bjohan/adf5355/adf5355/adf5355.pdf

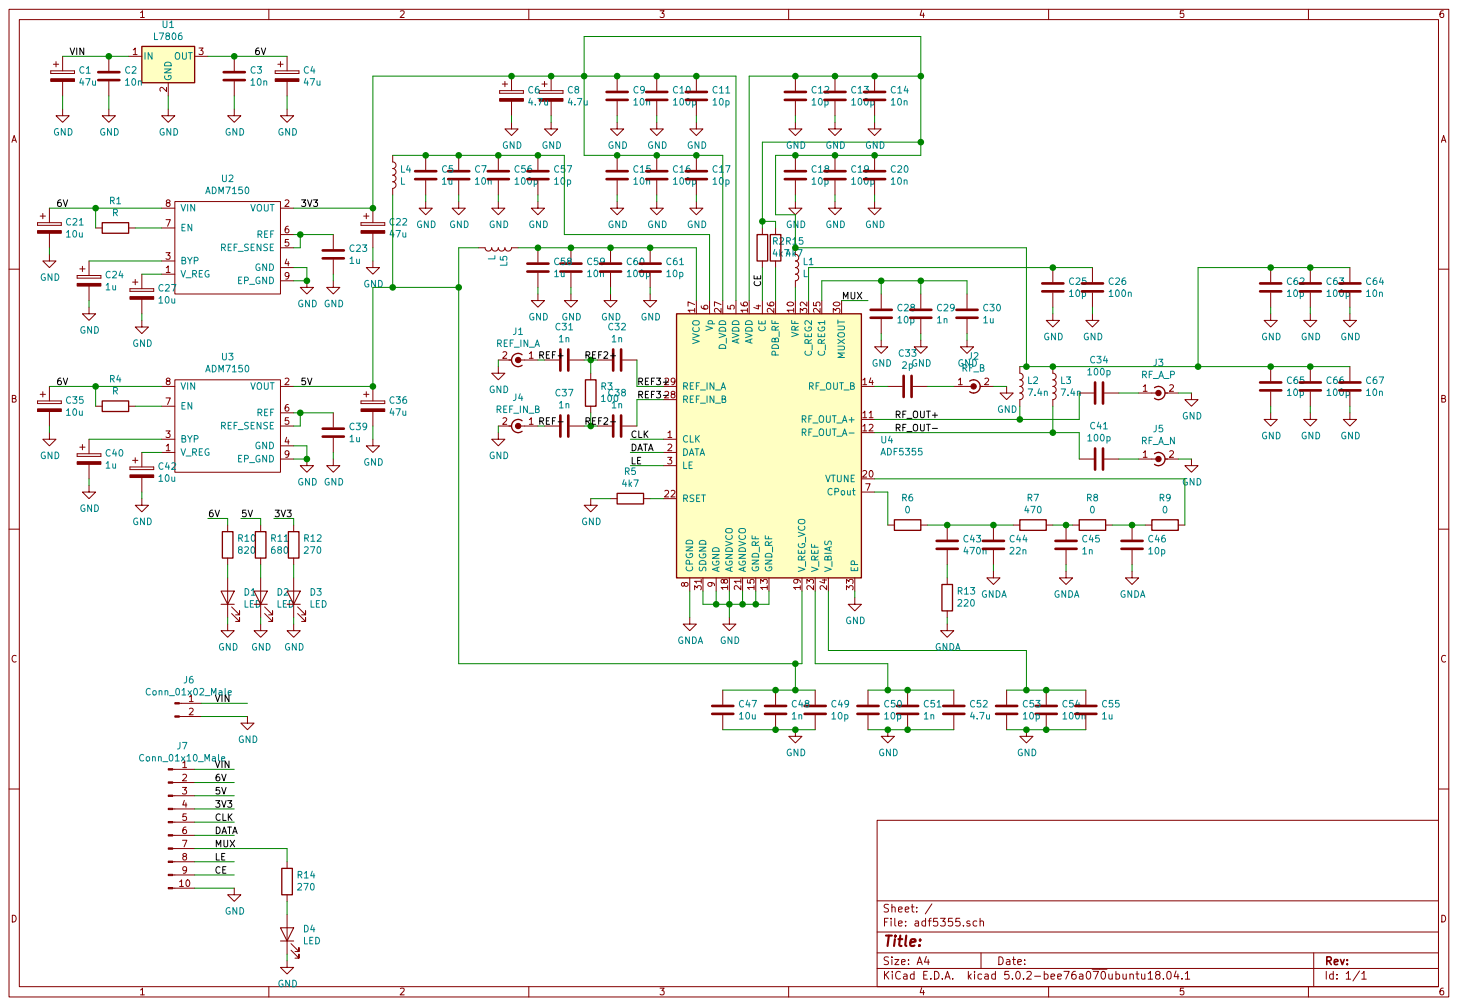
[picture p1: page 1]

9 U4ADF5355 V_REG 1 VOUT 2 BYP 3 GND 4 REF_SENSE 5 REF EN 6

47u GND GND GND GND

Id: 1/1 Title: File: adf5355.sch Sheet: /
