bjohan/adf5355/adf_arduino_adapter/adf_arduino_adapter/adf_arduino_adapter.kicad_pcb

## KiCad design adf_arduino_adapter/adf_arduino_adapter/adf_arduino_adapter.kicad_pcb (2019-05-01)

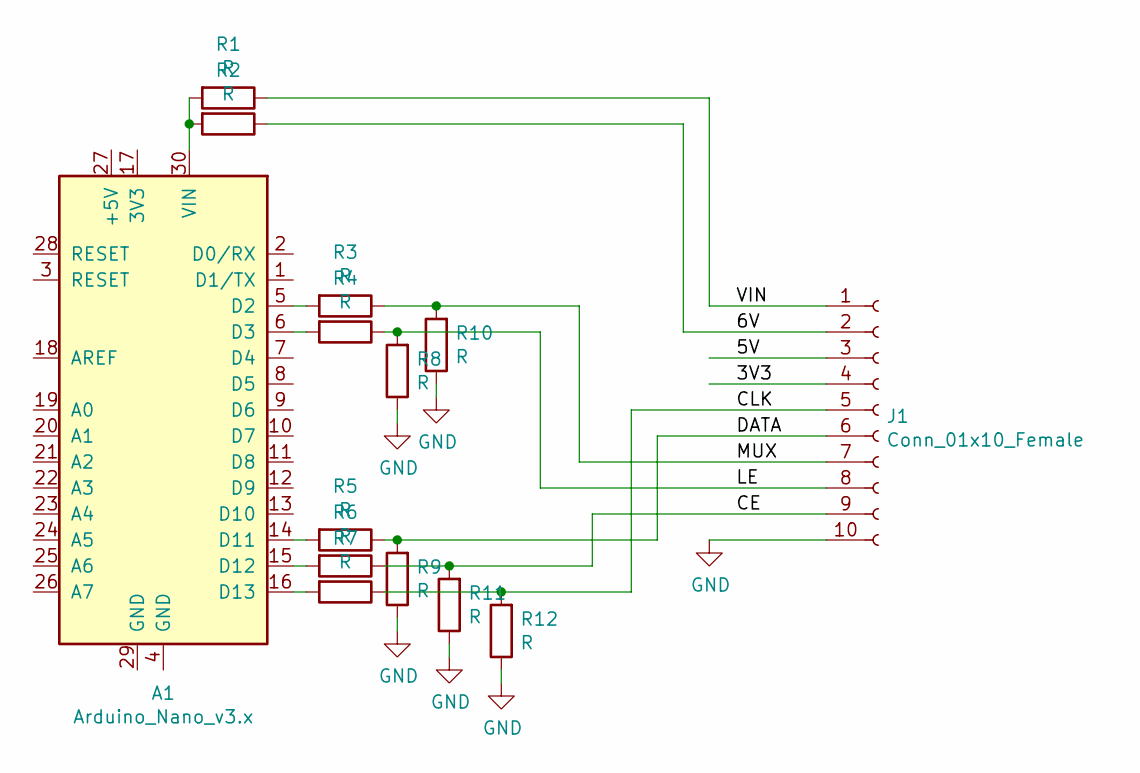
[picture p2: schematic adf_arduino_adapter.sch]

Parts:
A1: Arduino_Nano_v3.x; Arduino_Nano
J1: Conn_01x10_Female; Molex_KK-254_AE-6410-10A_1x10_P2.54mm_Vertical
R1, R2, R3, R4, R5, R6, R7, R8, R9, R10, R11, R12: R; R_1206_3216Metric_Pad1.42x1.75mm_HandSolder

Connections:
/3V3: J1.4
/5V: J1.3
/6V: J1.2, R2.1
/CE: J1.9, R6.1, R11.2
/CLK: J1.5, R7.1, R12.2
/DATA: J1.6, R5.1, R9.2
/LE: J1.8, R4.1, R8.2
/MUX: J1.7, R3.1, R10.2
/VIN: J1.1, R1.1
GND: J1.10, R8.1, R9.1, R10.1, R11.1, R12.1
unnamed: A1.5 (D2), R3.2
unnamed: A1.6 (D3), R4.2
unnamed: A1.14 (D11), R5.2
unnamed: A1.15 (D12), R6.2
unnamed: A1.16 (D13), R7.2
unnamed: A1.30 (VIN), R1.2, R2.2

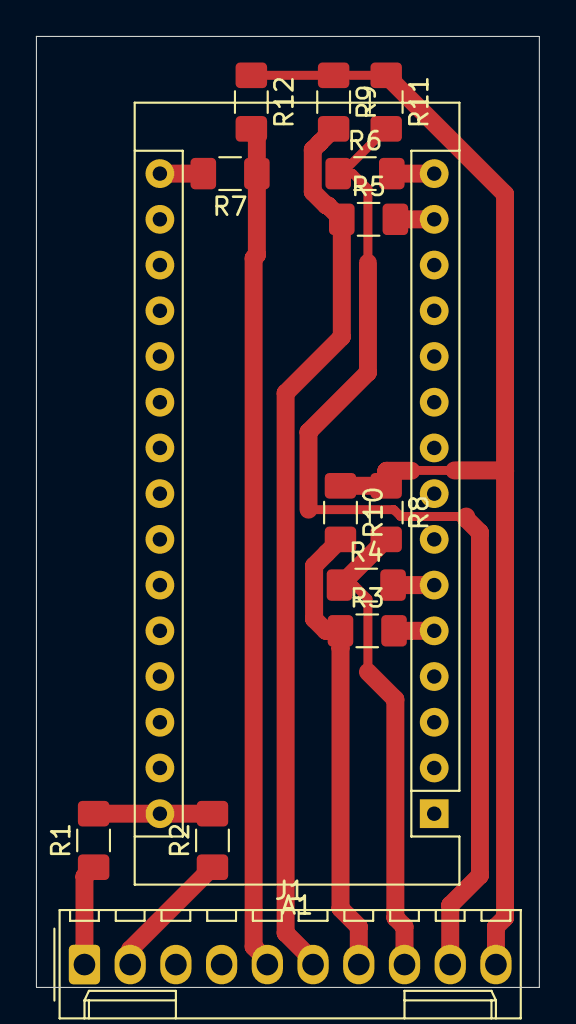
[picture p3: board adf_arduino_adapter.kicad_pcb from above]

Board: 2 copper layers, 27.9 x 52.8 mm, 14 parts (0 on the bottom side), 14 nets.
