bjohan/adf5355/adf5355/adf5355.kicad_pcb

## KiCad design adf5355/adf5355.kicad_pcb (2019-01-26)

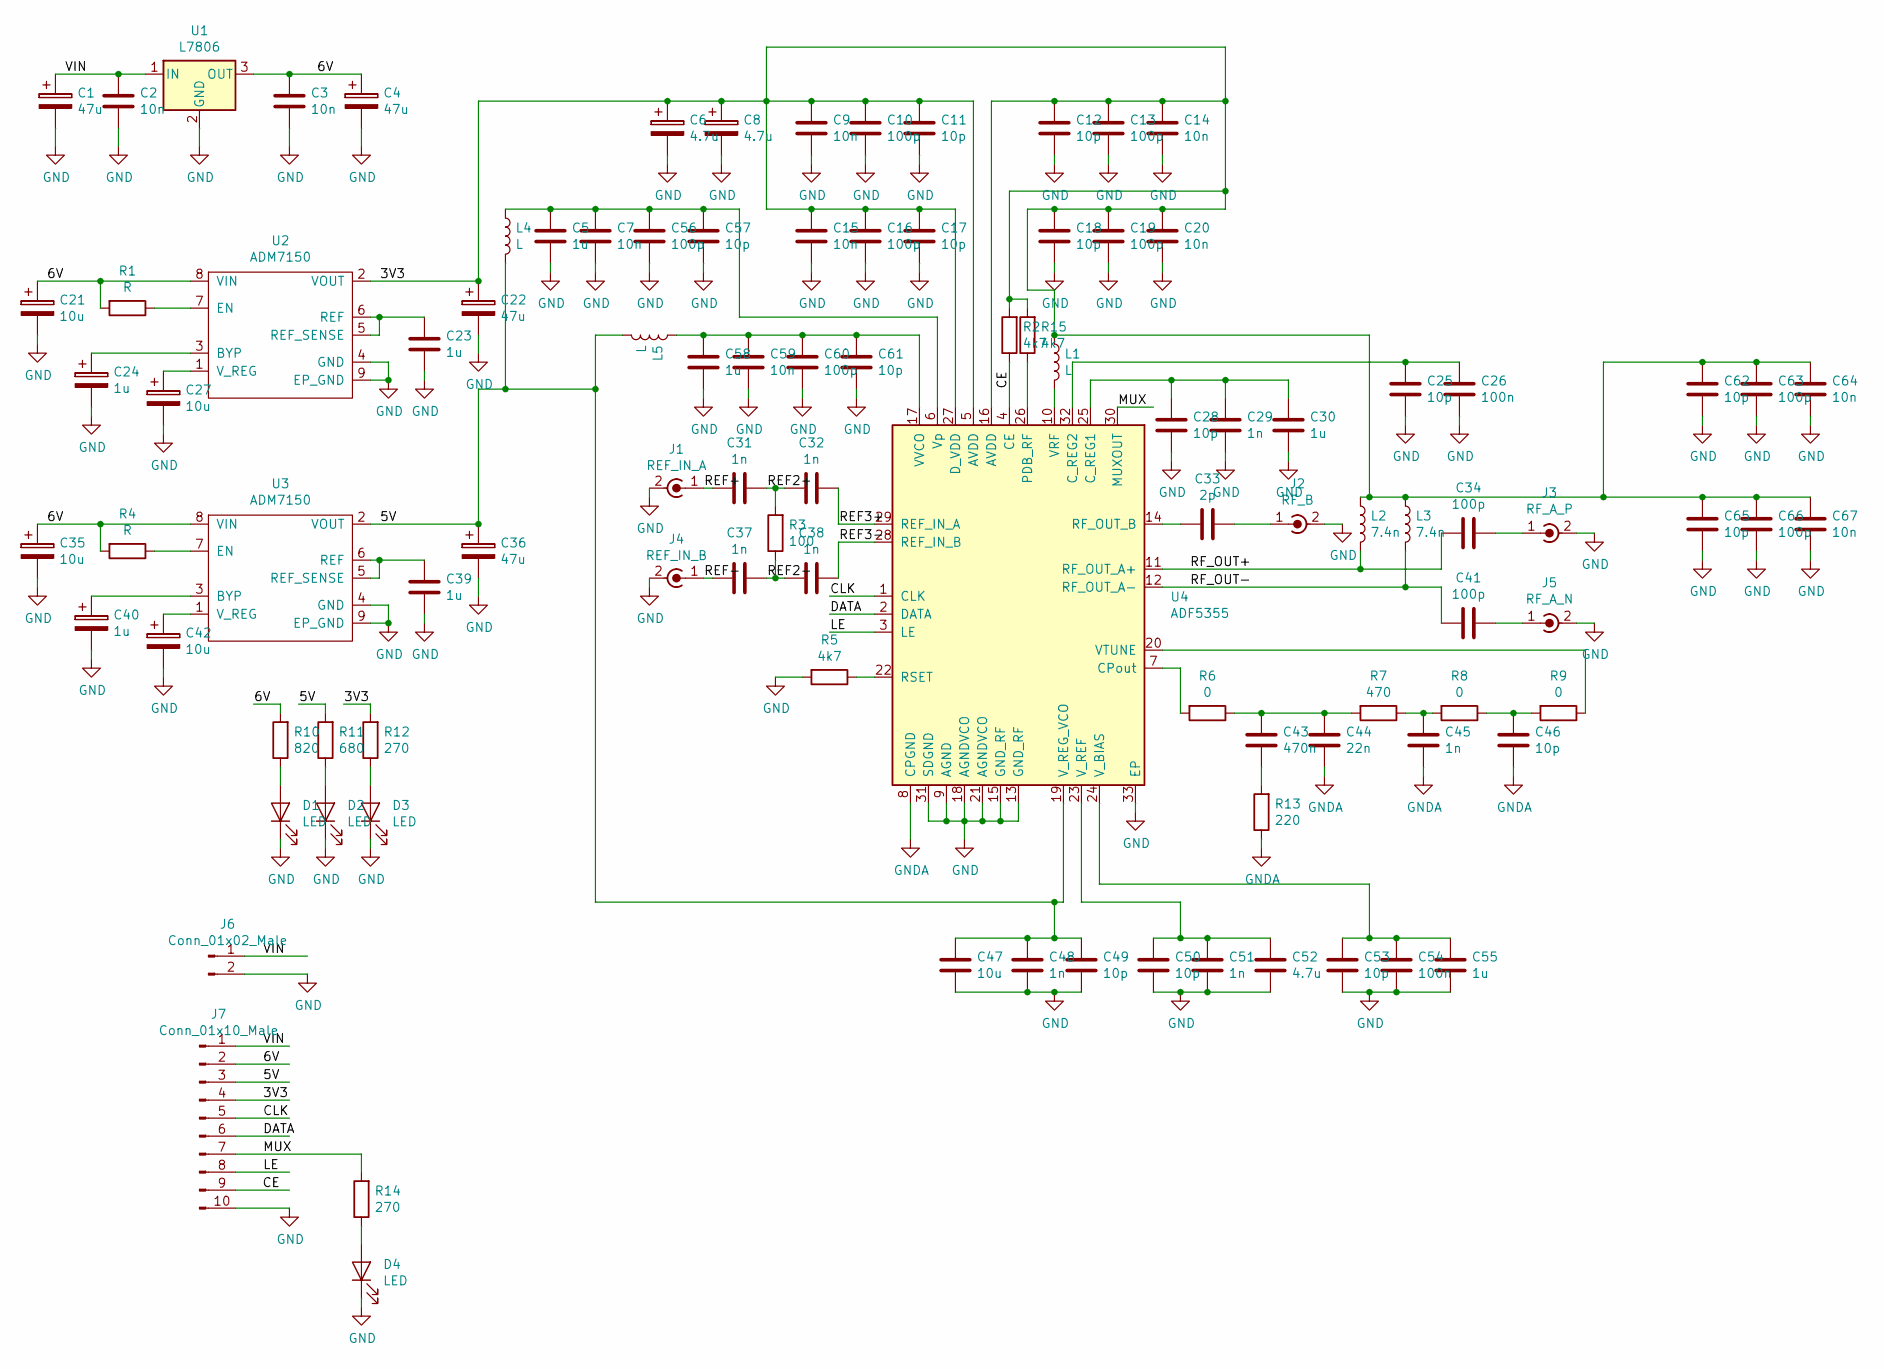
[picture p4: schematic adf5355.sch]

Parts:
C1, C4, C22, C36: 47u; CP_Elec_4x4.5
C2, C3: 10n; C_0805
C5, C30, C55, C58: 1u; C_0603
C6, C8: 4.7u; C_1812
C7, C9, C14, C15, C20, C59, C64, C67: 10n; C_0603
C10, C13, C16, C19, C34, C41, C56, C60, C63, C66: 100p; C_0603
C11, C12, C17, C18, C25, C28, C46, C49, C50, C53, C57, C61, C62, C65: 10p; C_0603
C21, C27, C35, C42, C47: 10u; C_1812
C23, C24, C39, C40: 1u; C_1206
C26, C54: 100n; C_0603
C29, C31, C32, C37, C38, C45, C48, C51: 1n; C_0603
C33: 2p; C_0603
C43: 470n; C_0603
C44: 22n; C_0603
C52: 4.7u; C_0603
D1, D2, D3, D4: LED; LED_0805
J1: REF_IN_A; SMA_THT_Jack_Straight
J2: RF_B; SMA_THT_Jack_Straight
J3: RF_A_P; SMA_THT_Jack_Straight
J4: REF_IN_B; SMA_THT_Jack_Straight
J5: RF_A_N; SMA_THT_Jack_Straight
J6: Conn_01x02_Male; Molex_KK-6410-02_02x2.54mm_Straight
J7: Conn_01x10_Male; Molex_KK-6410-10_10x2.54mm_Straight
L1, L4, L5: L; C_0805_HandSoldering
L2, L3: 7.4n; C_0805_HandSoldering
R1, R4: R; R_0805
R2, R5, R15: 4k7; R_0805
R3: 100; R_0805
R6, R8, R9: 0; R_0603
R7: 470; R_0603
R10: 820; R_0805
R11: 680; R_0805
R12, R14: 270; R_0805
R13: 220; R_0603
U1: L7806; TO-220-3_Vertical
U2, U3: ADM7150; SOIC-8-1EP_3.9x4.9mm_Pitch1.27mm
U4: ADF5355; LFCSP-32-1EP_5x5mm_P0.5mm_EP3.25x3.25mm

Connections:
/3V3: C6.1, C8.1, C9.1, C10.1, C11.1, C12.1, C13.1, C14.1, C15.1, C16.1, C17.1, C18.1, C19.1, C20.1, C22.1, C62.1, C63.1, C64.1, C65.1, C66.1, C67.1, J7.4, L1.1, L2.1, L3.1, R2.2, R12.2, R15.2, U2.2 (VOUT), U4.5 (AVDD), U4.16 (AVDD), U4.27 (D_VDD)
/5V: C36.1, C47.1, C48.1, C49.1, J7.3, L4.2, L5.2, R11.2, U3.2 (VOUT), U4.19 (V_REG_VCO)
/6V: C3.1, C4.1, C21.1, C35.1, J7.2, R1.2, R4.2, R10.2, U1.3 (OUT), U2.8 (VIN), U3.8 (VIN)
/CE: J7.9, R2.1, U4.4 (CE)
/CLK: J7.5, U4.1 (CLK)
/DATA: J7.6, U4.2 (DATA)
/LE: J7.8, U4.3 (LE)
/MUX: J7.7, R14.2, U4.30 (MUXOUT)
/REF2+: C31.1, C32.2, R3.2
/REF2-: C37.1, C38.2, R3.1
/REF3+: C32.1, U4.29 (REF_IN_A)
/REF3-: C38.1, U4.28 (REF_IN_B)
/REF+: C31.2, J1.1 (In)
/REF-: C37.2, J4.1 (In)
/RF_OUT+: C34.2, L2.2, U4.11 (RF_OUT_A+)
/RF_OUT-: C41.2, L3.2, U4.12 (RF_OUT_A-)
/VIN: C1.1, C2.1, J6.1, J7.1, U1.1 (IN)
GND: C1.2, C2.2, C3.2, C4.2, C5.2, C6.2, C7.2, C8.2, C9.2, C10.2, C11.2, C12.2, C13.2, C14.2, C15.2, C16.2, C17.2, C18.2, C19.2, C20.2, C21.2, C22.2, C23.2, C24.2, C25.2, C26.2, C27.2, C28.2, C29.2, C30.2, C35.2, C36.2, C39.2, C40.2, C42.2, C47.2, C48.2, C49.2, C50.2, C51.2, C52.2, C53.2, C54.2, C55.2, C56.2, C57.2, C58.2, C59.2, C60.2, C61.2, C62.2, C63.2, C64.2, C65.2, C66.2, C67.2, D1.1 (K), D2.1 (K), D3.1 (K), D4.1 (K), J1.2 (Ext), J2.2 (Ext), J3.2 (Ext), J4.2 (Ext), J5.2 (Ext), J6.2, J7.10, R5.2, U1.2 (GND), U2.4 (GND), U2.9 (EP_GND), U3.4 (GND), U3.9 (EP_GND), U4.9 (AGND), U4.13 (GND_RF), U4.15 (GND_RF), U4.18 (AGNDVCO), U4.21 (AGNDVCO), U4.31 (SDGND), U4.33 (EP)
GNDA: C44.2, C45.2, C46.2, R13.1, U4.8 (CPGND)
unnamed: C5.1, C7.1, C56.1, C57.1, L4.1, U4.6 (Vp)
unnamed: C23.1, U2.5 (REF_SENSE), U2.6 (REF)
unnamed: C24.1, U2.3 (BYP)
unnamed: C25.1, C26.1, U4.32 (C_REG2)
unnamed: C27.1, U2.1 (V_REG)
unnamed: C28.1, C29.1, C30.1, U4.25 (C_REG1)
unnamed: C33.1, J2.1 (In)
unnamed: C33.2, U4.14 (RF_OUT_B)
unnamed: C34.1, J3.1 (In)
unnamed: C39.1, U3.5 (REF_SENSE), U3.6 (REF)
unnamed: C40.1, U3.3 (BYP)
unnamed: C41.1, J5.1 (In)
unnamed: C42.1, U3.1 (V_REG)
unnamed: C43.1, C44.1, R6.1, R7.2
unnamed: C43.2, R13.2
unnamed: C45.1, R7.1, R8.2
unnamed: C46.1, R8.1, R9.2
unnamed: C50.1, C51.1, C52.1, U4.23 (V_REF)
unnamed: C53.1, C54.1, C55.1, U4.24 (V_BIAS)
unnamed: C58.1, C59.1, C60.1, C61.1, L5.1, U4.17 (VVCO)
unnamed: D1.2 (A), R10.1
unnamed: D2.2 (A), R11.1
unnamed: D3.2 (A), R12.1
unnamed: D4.2 (A), R14.1
unnamed: L1.2, U4.10 (VRF)
unnamed: R1.1, U2.7 (EN)
unnamed: R4.1, U3.7 (EN)
unnamed: R5.1, U4.22 (RSET)
unnamed: R6.2, U4.7 (CPout)
unnamed: R9.1, U4.20 (VTUNE)
unnamed: R15.1, U4.26 (PDB_RF)

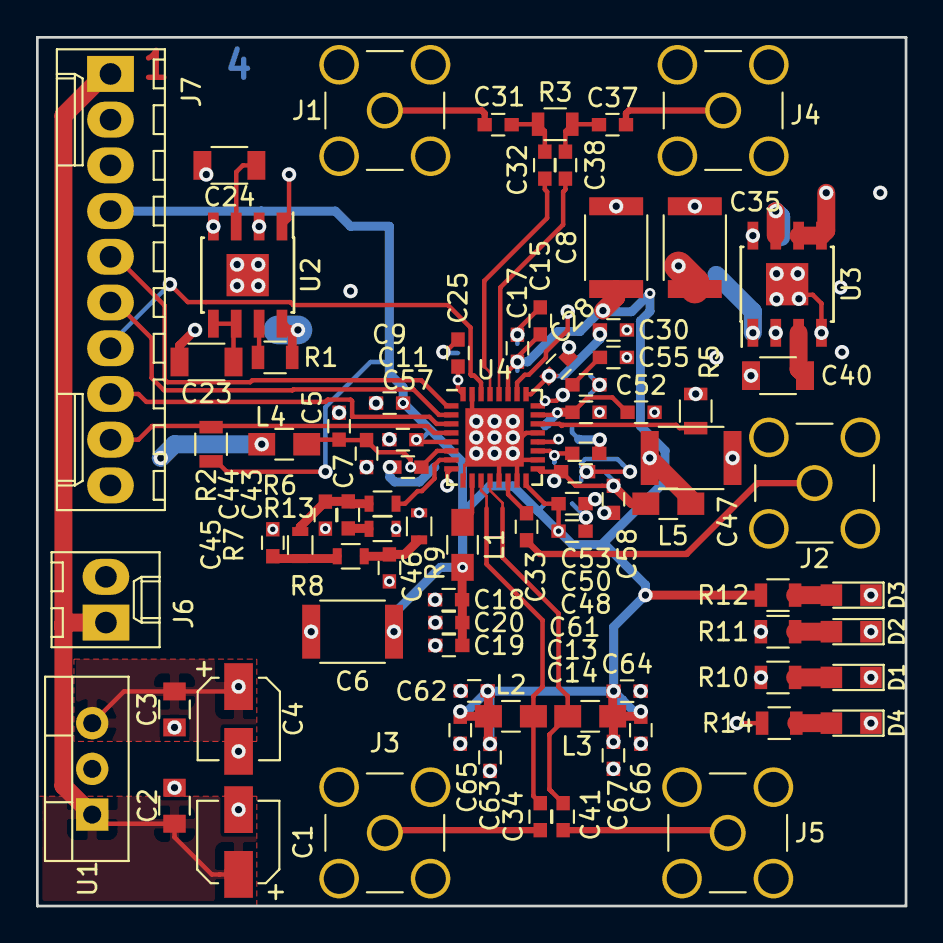
[picture p5: board adf5355.kicad_pcb from above]

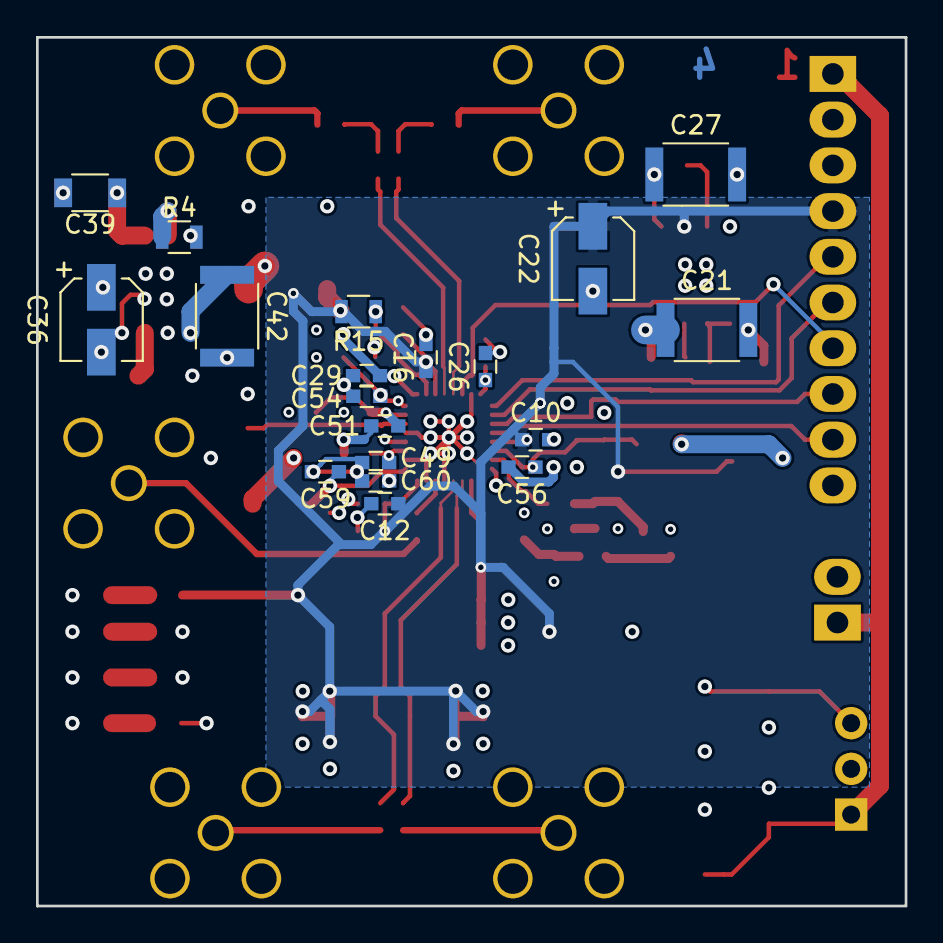
[picture p6: board adf5355.kicad_pcb from below]

Board: 4 copper layers, 48.3 x 48.3 mm, 102 parts (19 on the bottom side), 50 nets.
