bjohan/adf5355/(commit log)

2018-10-11 Initial checkin
    [adf5355.kicad_pcb, adf5355.sch]
2018-10-14 Placing more components
    [adf5355.kicad_pcb, adf5355.sch]
2018-10-15 More layout placement
    [adf5355.kicad_pcb]
2018-10-16 More placing
    [_saved_adf5355.sch, adf5355.kicad_pcb]
2018-10-18 More work on layout, decided to switch to four layer board
    [adf5355.sch]
2018-10-22 Started routing
    [adf5355.kicad_pcb]
2018-10-24 Placement of LDOs and components
    [adf5355.kicad_pcb]
2018-10-29 More layout
    [adf5355.kicad_pcb]
2018-12-16 Layout fully routed, now needs finilizing, moving vias to make better powerplanes, route diffpairs properly etc.
    [adf5355.kicad_pcb, adf5355.sch]
2018-12-23 Added some capacitors, better power planes etc. Needs fixing transmission lines and checking component placement for solderability. Also the c_reg capacitors probably needs to be closer to the pin
    [_saved_adf5355.sch, adf5355.kicad_pcb, adf5355.sch]
2018-12-23 Added power plane for coarse input regulator
    [adf5355.kicad_pcb]
2018-12-23 Fixed transmission line widths
    [adf5355.kicad_pcb]
2018-12-26 Added layer markings
    [adf5355.kicad_pcb]
2019-01-26 Found via that caused DRC error at manufacturer
    [adf5355.kicad_pcb]
2019-01-26 Fixed silk screen and added files sent for production
    [adf5355-B.Cu.gbr, adf5355-B.Mask.gbr, adf5355-B.Paste.gbr, adf5355-B.SilkS.gbr, adf5355-Edge.Cuts.gbr, adf5355-F.Cu.gbr, adf5355-F.Mask.gbr, adf5355-F.Paste.gbr]
2019-04-21 Addded adapterboard
    [adf_arduino_adapter.kicad_pcb, adf_arduino_adapter.sch]
2019-04-23 Started writing sketch, current version can blink the muxout led
2019-05-01 more frac n
    [adf_arduino_adapter.kicad_pcb]
2022-11-22 Added arduino fw
2022-11-23 cleaned prints
